jbromley/led-cube-4x4x4/docs/perfboard-layout.tiff

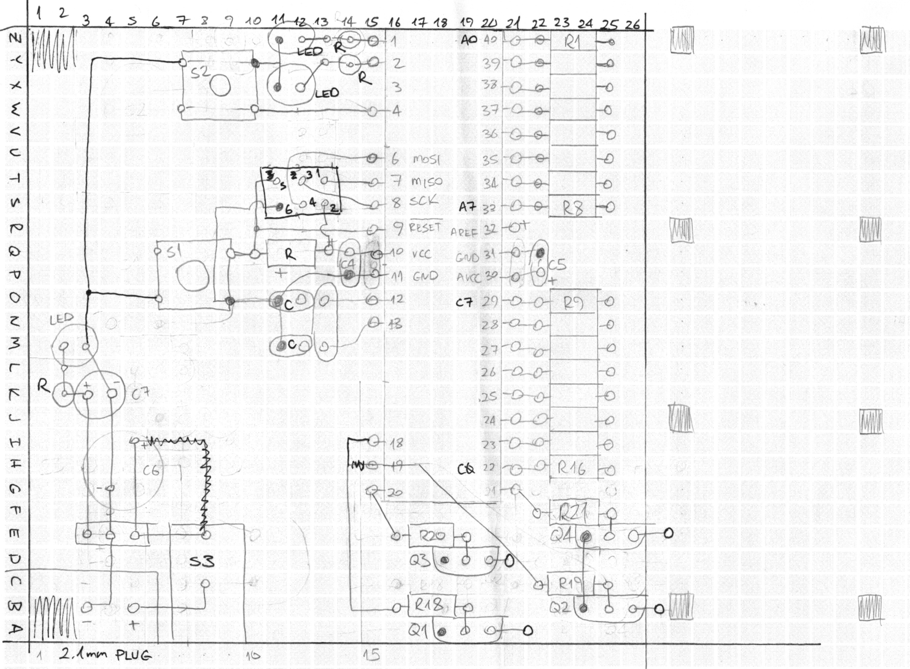
docs/perfboard-layout.tiff
