jbromley/led-cube-4x4x4/(list of files, drawings)

Other design files:
schematics/led-cube-4x4x4.pcb
