jbromley/led-cube-4x4x4/(commit log)

2011-12-13 Initial import.
    [led-cube-4x4x4.sch]
2011-12-16 Completed circuit schematic.
    Circuit attributes still need to be set.
    [led-cube-4x4x4.sch]
2011-12-16 Clean up schematic and add a power switch.
    Cleaned up the output bus and transistor bank wiring. Other general
    re-arrangement to get a clean schema. Added a power switch to the
    voltage regulator block.
    [led-cube-4x4x4.sch]
2011-12-16 Added footprint and value attributes.
    Added footprint and value attributes for most components to allow
    layout to be done in PCB. There are still a few components for
    which I need to find footprints.
    [led-cube-4x4x4.sch]
2011-12-16 Changed out power and anode connectors.
    Replaced the power jumper with a power jack and added the
    corresponding footprint. Broke the 16-pin anode connector into
    two eight-pin connectors to get a straighter layout for anode
    wiring.
    [led-cube-4x4x4.sch]
2011-12-16 Added an empty PCB file for project.
    Created a PCB file with correct parameters for the LED cube.
    Also added PCB intermediate and backup files to the git ignore
    file.
    [led-cube-4x4x4.pcb]
2011-12-17 Added footprints for connectors.
    [led-cube-4x4x4.sch]
2011-12-17 Added footprint for momentary switches.
2011-12-19 Changed code to use led_green, led_red functions.
    The code (boot_msg) was just bit-twiddling to blink the LEDs.
    Changed this to use the functions for this purpose.
2011-12-19 Added PCB footprint library.
2011-12-19 Corrected spelling error in file headers.
    [draw.c, effect.c, frames.c]
2011-12-20 Corrected resistor values and made footprints invisible.
    Corrected the values of the anode and transistor base resistors.
    Also made the footprint attributes of the connectors invisible.
    [led-cube-4x4x4.sch]
2011-12-21 Modified momentary switch. Added toggle switch.
    Modified the momentary switch to be a smaller model. Added a
    footprint for the micro-toggle switch.
2011-12-21 Added switch footprints.
    Added footprints for the tactile and power switches. Did some slight
    circuit cleanup around the AVCC and AREF pins.
    [led-cube-4x4x4.sch]
2011-12-21 Fixed resistor to pin mappings.
    I had reversed the resistor references so all the wires from the
    microcontroller to the resistors were crossed. Renumbered the
    resistors to respect pin order and produce straight wires.
    [led-cube-4x4x4.sch]
2011-12-22 Adjusted current sink pin/resistor labels.
    The references for the current sink transistors and resistors
    were not correct. Changed them to match the Instructables
    schematic.
    [led-cube-4x4x4.sch]
2011-12-22 Laid out PCB for LED cube.
    Laid out the main control circuitry for a PCB board. Also added the
    netlist file since I had to hand-edit it to eliminate some bad pin
    names.
    [led-cube-4x4x4.pcb]
2011-12-22 Added blank PCB board file.
2011-12-31 Added symbol and footprints for LED cube.
    Added a gschem symbol (from djboxsym) and pcb footprint for the
    LED 4x4x4 cube to allow a circuit board layout.
2012-01-27 Reduced delays in rain animation.
    The long delays in starting to fall and after the fall made the
    rain animation too slow. Lowered the delay amounts.
    [main.c]
2012-01-28 Added perfboard layout diagram.
    Added hand-drawn layout that was used for the LED cube.
2012-01-28 Added random walk animation. Tweaked others.
    Added a random walk animation to the cube. Also tweaked the others
    for number of repetitions and number of LEDs lit.
